openredl/openredl/Firmware/OpenREDL_lib/README.md

# OpenReDLlib Library

The OpenReDLlib is a library to be used in dataloggers of the project OpenReDL, in which dataloggers for renewable energy learning and other applications are being developed.

To work, OpenReDLlib need the following libraries:
- RTClib
- I2Cdev
- ADS1115

Install them by Arduino IDE > Sketch > Include Library > Add .ZIP Library.

For detail information look at the project documentation in:
https://github.com/openredl/openredl

# OpenReDLlib Library
Author: adjim - PPRE, Energy Technology, University of Oldenburg
