openredl/openredl/Hardware/089_23_Hauptplatine_mit_Überspannungsschutz_SCH.PDF

10K

R33

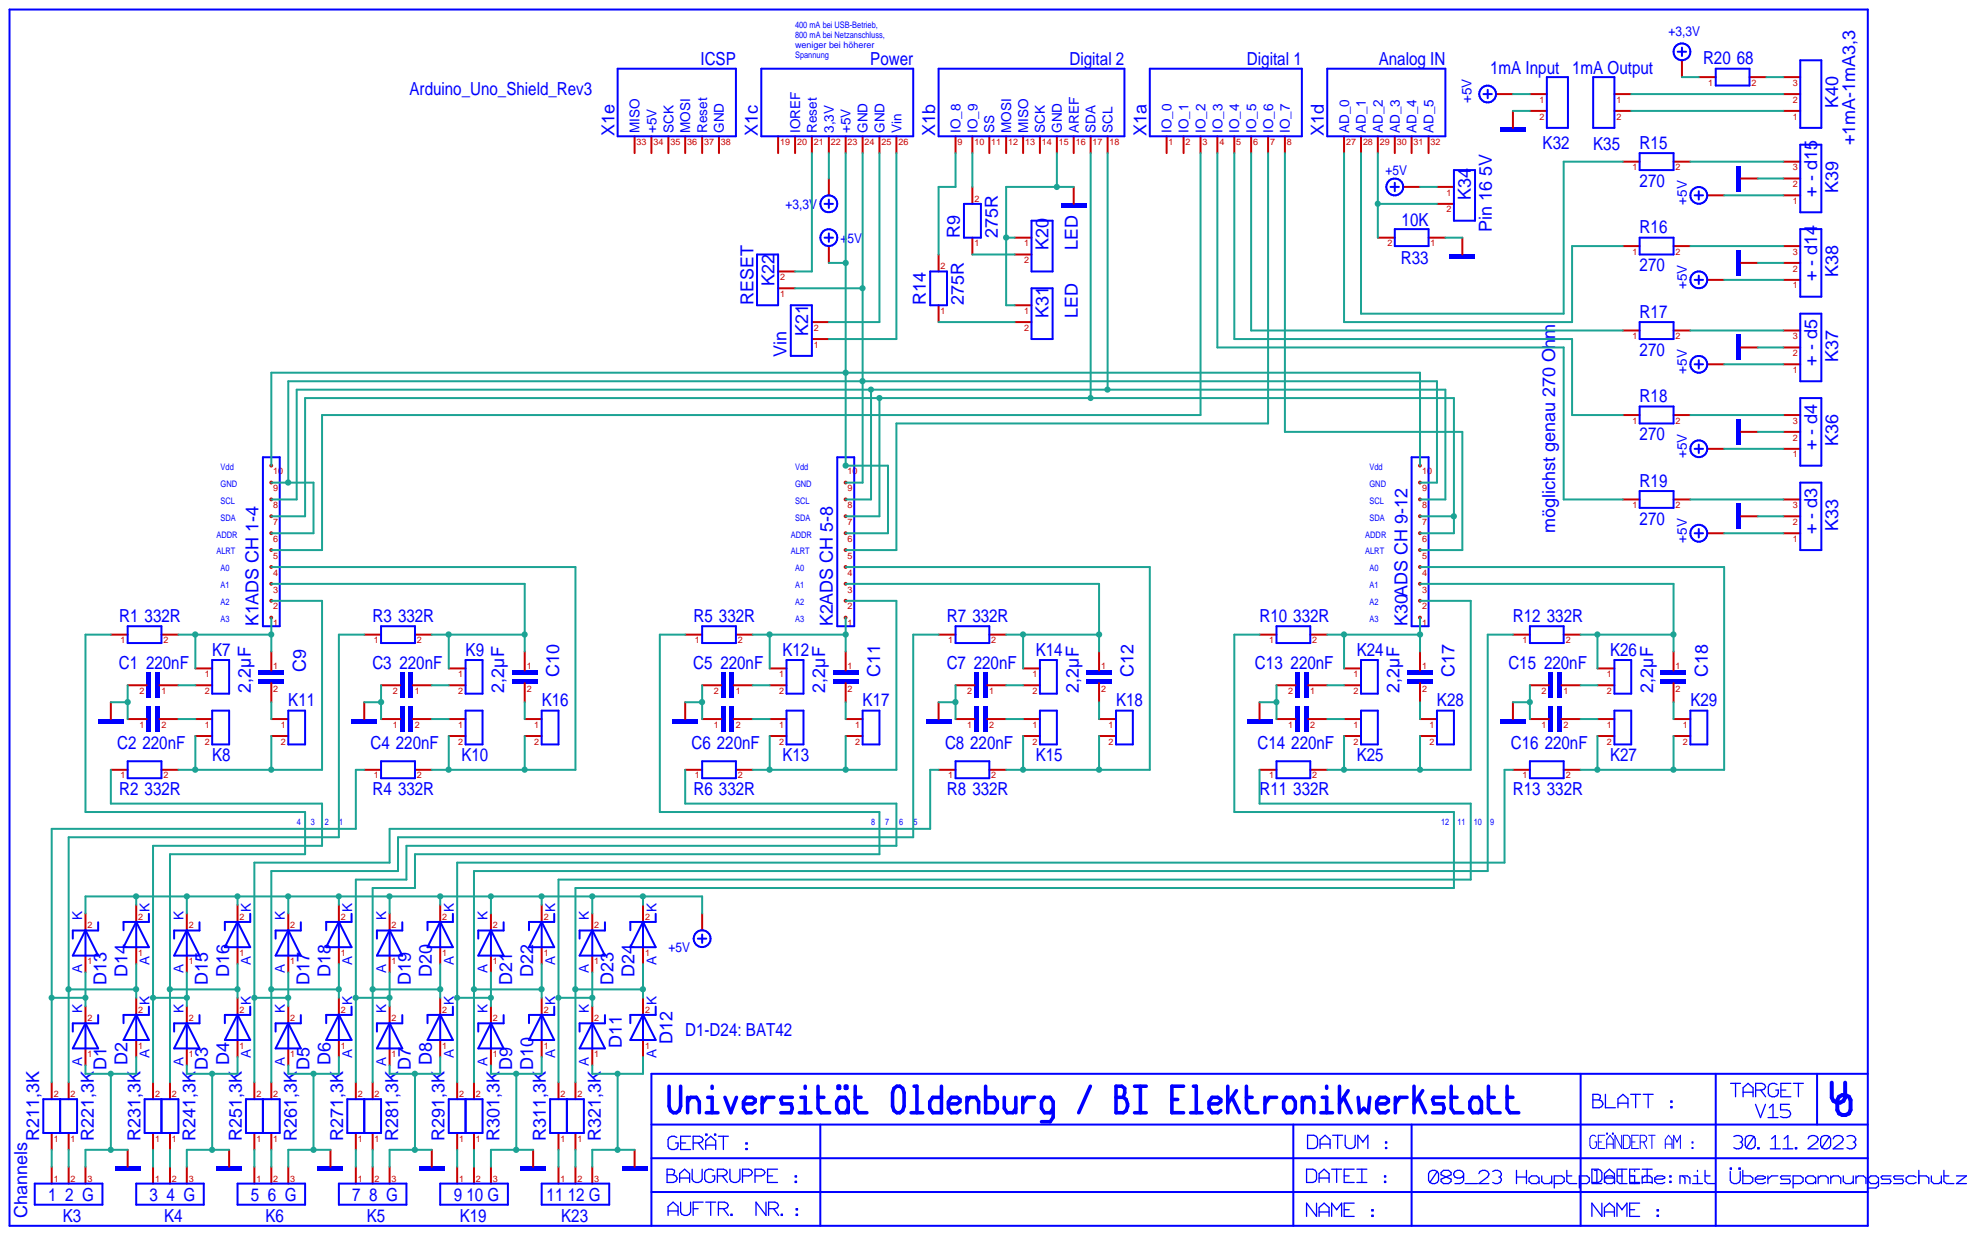
[picture p4: page 1]

400 mA bei USB-Betrieb,
800 mA bei Netzanschluss,
weniger bei höherer
Spannung
