openredl/openredl/Hardware/Arduinoshield_mit_zwei_ADS1115_SMD_SCH.PDF

# K19 GND

## GND 38

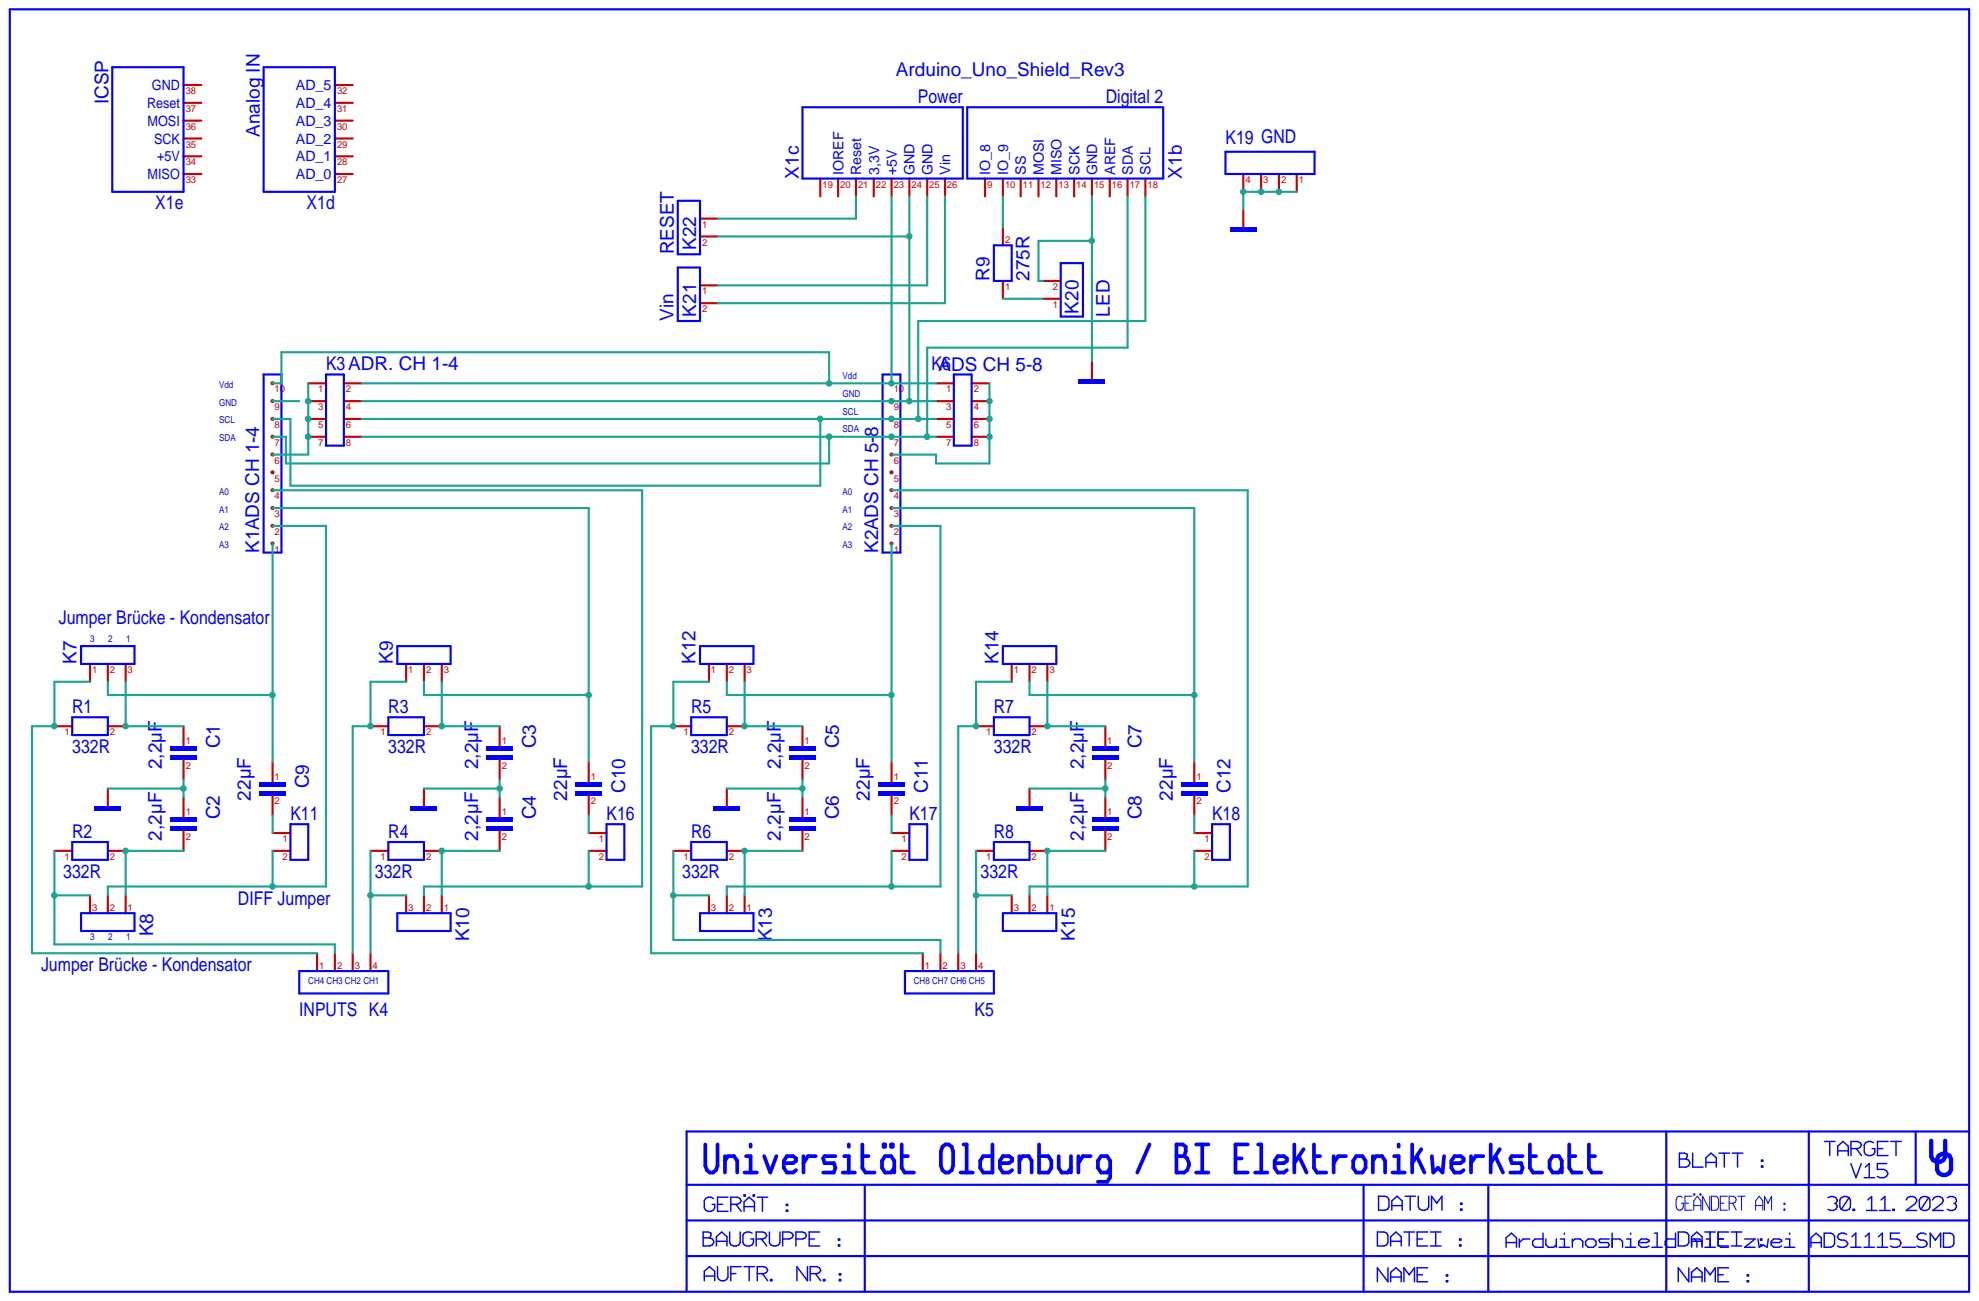
[picture p5: page 1]

Jumper Brücke - Kondensator K⁷

Jumper Brücke - Kondensator K⁸
