openredl/openredl/Hardware/089_23_Hauptplatine_mit_Überspannungsschutz_PCB.PDF

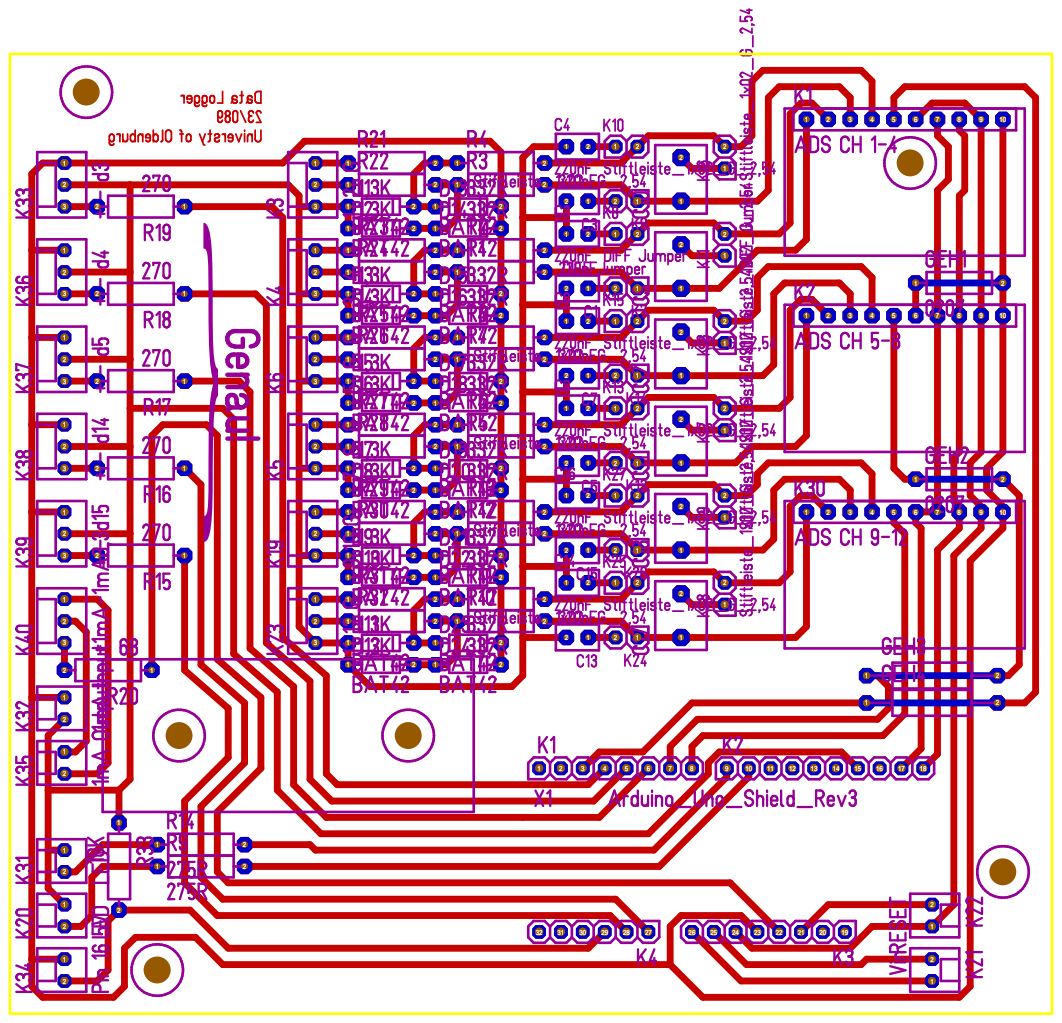
[picture p6: page 1]
