openredl/openredl/Hardware/Arduinoshield_mit_zwei_ADS1115_SMD_PCB.PDF

70

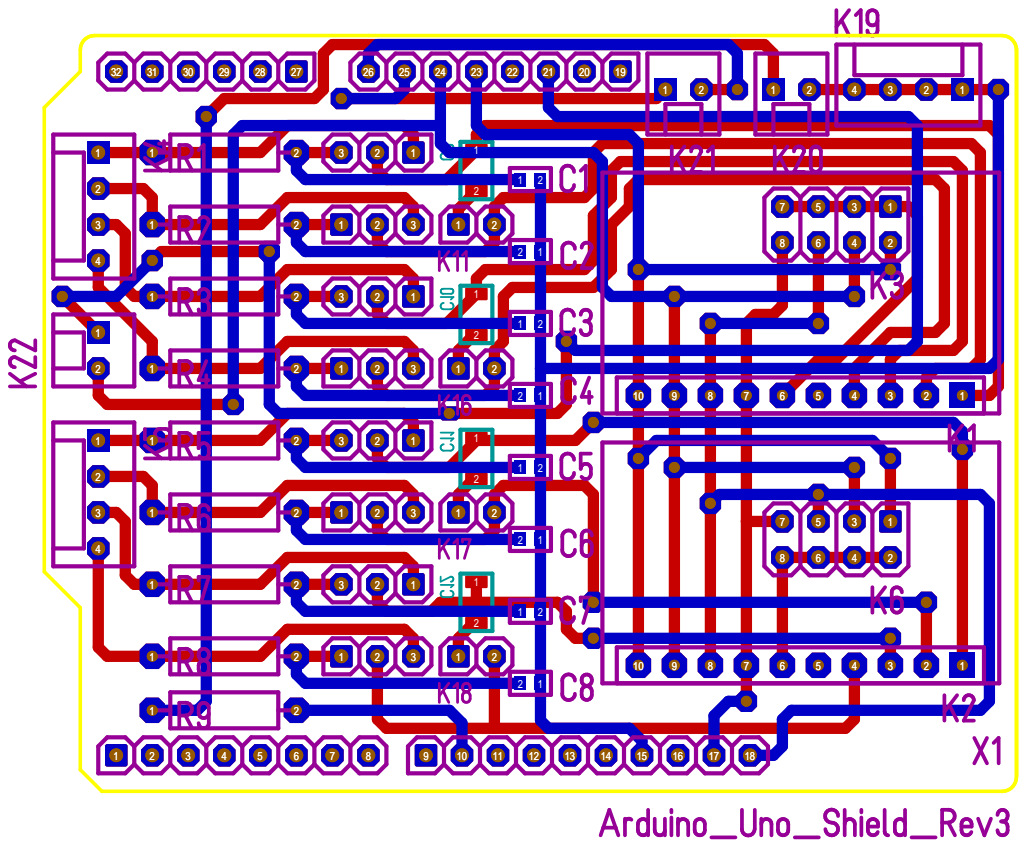
[picture p7: page 1]
