openredl/openredl/WinterLab_CodeTemplates/winterlab_intro/real_time_plot_winterlab_intro.py

"""Real Time Plot script template
To execute it:
- activate the right environment: conda activate openredl-env
- execute the script: python real_time_plot_winterlab_intro.py
"""

import pyopenredl.realtimeplotutils as rtp

#####################################################################
## Guidelines #######################################################
#####################################################################
### 1. Port Selection ###############################################
#####################################################################
# Default is autoselect.
# If autoselect does not work as desired, the port can be selected manually.
# The right port of the Datalogger in the computer to use have to be given.
# The port name can be found in:
# a) Arduino Ide > tools > port
# b) in Windows: device manager.
# Common port names include:
# port = '/dev/ttyACM0'
# port = '/dev/rfcomm0'
# port = 'COM3'
# terms to search automatically for a port.
terms = ["D307R956", "arduino", "2341:0043"]
# Automatic port selection.
port = rtp.autoselect_port(terms, 0)
#####################################################################
### 2. Plot Length ##################################################
#####################################################################
# how many units of data should be plotted
# unit = "seconds" # points/seconds
# amount = 5*60 # how many units should be kept in the plot

#####################################################################
########## Data to Plot #############################################
#####################################################################
# Which data columns should be plotted?
# Array of subarrays. Each subarray "[]" is a plotting axis.
# y_axis_n can be given by column_number or column_name
# column_number starts with column 0 (datetime)
# Possible subarrays format:
#       [y_axis1, y_axis2...]
#       [{"y":[y_axis1, y_axis2...]}]
#       [{"x":x_axis, "y":[y_axis1, y_axis2...], "<matplotlib_plot_kwd:value}]
#
#       [1,2,3,4], # example multiple y_axis with column0/datetime as x_axis
#       [1],  # example one y_axis with column0/datetime as x_axis
#       [2, "P1real[W]"], # example with y_axis as column number and as column_name
#       [{"x":2,"y":[2,"P1real[W]"]}], # example with other column as x _axis
#       [{"x":2,"y":[3], "linestyle":"none"}], # example with extra plot kwd,
#       [{"x":2,"y":[3,4], "linestyle":"none"}], # example with
#
# Headers example: ['datetime', 'DIFF1_mean[mV]', 'DIFF1_max[mV]', 'DIFF2_mean[mV]', 'DIFF2_max[mV]', 'notes']
# example:
# columns_to_plot = [
#                     [1,2],
#                     [3,4],
#                     [{"x":2,"y":[3]}]
#                    ]

#####################################################################
########## Plotting Profiles Definitions ########################################
#####################################################################

winterlab_intro_profile = {
    "unit": "seconds",  # Unit: points or seconds
    "amount": 60 * 60,  # Amount: how many units should be kept in the plot
    "columns_to_plot":
    # H<datetime,DIFF1_mean[mV],DIFF2_mean[mV],DIFF3_mean[mV],DIFF4_mean[mV],notes>
    [[1], [2], [3]],
}

#####################################################################
########## Run Plotting Code ########################################
#####################################################################
# Select the profile to plot
plot_profile = winterlab_intro_profile
# Create data logger object and run it!
dl = rtp.SerialDL(
    port=port,
    points=plot_profile["amount"],
    cols_to_plot=plot_profile["columns_to_plot"],
    select=plot_profile["unit"],
)
dl.run()
