openredl/openredl/(commit log)

2024-11-05 simplified and corrected, default date added
    [logutils.py]
2024-11-05 add select column in select data, fixed selected column by number, returning columns available and selected
    [logutils.py]
2024-11-06 simplified to sample each 2s, 4 diff channels, storing only mean
2025-10-27 plot last values, fix read first headers, comment corrections
    [realtimeplotutils.py]
2026-10-23 introduced shunt resistance and changed label
